zJudGenie/FPGATriggerer/(commit log)

2024-04-24 Initial commit. Working UART Receiver and Edge Detector
2024-05-01 Implemented delay_module, fixed bugs in cmd_handler FSM
    [cmd_handler.v, delay_module.v, main.v, uart.v]
2024-05-01 Moved UART commands to commands.v
2024-05-02 Lowered clock to 166.665MHz, implemented FSM in delay_module, added ARM command for the delay_module
2024-05-09 Removed debug led in favor of GAO, fixed serial read to registers
    [cmd_handler.v, delay_module.v, digital_edge_detector.v, main.v]
2024-05-11 Created pulse_extender module, finally fixed cmd_handler bug when reading multiple data bytes
    [cmd_handler.v, commands.v, delay_module.v, main.v, pulse_extender.v]
2024-05-19 Implemented Python UART API
2024-05-22 Implemented target resetter module
    [FPGATriggererPythonAPI.py, commands.v, gowin_rpll.v, main.v, pulse_extender.v, target_resetter.v]
2024-05-30 Modified hold-off size, found bug with hold off, the value set in the register is not read
    [FPGATriggererPythonAPI.py, digital_edge_detector.v]
